xmyoot/esp32-c3-smart-scale/docs/client_request.md

Low Power PCB Design for ESP32-C3-Mini-1U with Load Cell and LiPo Support Summary
Need custom PCB design for a **low-power smart scale**.

Main requirements:

* ESP32-C3-MINI-1U
* Wi-Fi + BLE
* external antenna
* USB-C charging for 1S 3.7 V 3000 mAh battery
* battery level measurement
* load cell weight measurement
* very low sleep current
* factory programming pads
* compact, low-cost design

Deliverables:

* schematic
* PCB layout
* BOM
* Gerbers
* pick and place
* assembly files
* bring-up notes

Please recommend the cheapest sensible architecture, including:

* load-cell ADC
* charger IC
* battery measurement method
* regulators / power path
* low-power strategy

Board should be suitable for a real product, not a dev board clone.
