xmyoot/esp32-c3-smart-scale/docs/design_brief.html

ESP32-C3 Smart Scale

Engineering Design Brief | Rev A0 | 2026-04-02

Engineering Design Brief

# Low-Power ESP32-C3 Smart Scale Main Board

This project is a compact, battery-backed smart-scale PCB built around the ESP32-C3-MINI-1U with external antenna support, a dedicated HX711 load-cell ADC, USB-C charging for a 1S 3000 mAh LiPo, and explicit low-sleep-current design choices. The cheapest sensible product architecture is a battery-always-present system using a linear charger, a low-IQ 3.0 V rail, a switched battery divider, and direct USB Serial/JTAG routing into the ESP32-C3 so there is no USB-UART bridge tax.

<40 uA

Target Deep-Sleep Current
system-level goal, excluding charger leakage variance

24-bit

Weight Front End
HX711, 10 SPS preferred

3.0 V

Main Rail
chosen to fit ESP32-C3 supply window with low cost

500 mA

Charge Setpoint
initial recommendation for thermal and USB simplicity

45 × 35 mm

Board Envelope
explicit first-pass assumption

01

## Design Options

Recommended

Option A

### LDO-Based Battery-Backed Product Board

Use the battery as the always-present energy source, charge it from USB-C with MCP73831, regulate the system with a low-IQ TLV75530, and measure the bridge with HX711. Route USB D+/D- straight into the ESP32-C3 USB Serial/JTAG pins.

Pros

Lowest BOM cost while staying product-grade

No USB-UART bridge or power-path PMIC overhead

Simple firmware and assembly flow

Cons

Not optimized for battery-less USB operation

Active efficiency lower than a switching rail

Charge/load interaction must be budgeted

Verdict: best fit for “cheapest sensible architecture” and a battery-backed scale product.

Option B

### Buck-Regulated Battery System

Keep the same charger and metrology path, but replace the LDO with a low-IQ switching regulator. This improves active efficiency and thermal margin during Wi-Fi bursts.

Pros

Better energy use during radio activity

Lower thermal stress at higher average load

More headroom if the feature set grows

Cons

Higher BOM cost

More EMI and layout discipline required

Solves a problem the present use case may not have

Verdict: technically cleaner for efficiency, but not the cheapest sensible first product architecture.

Option C

### Premium Metrology + Power-Path Platform

Use a higher-spec ADC and a charger with full power-path behavior so the board behaves more like a mains-attached product while charging and running.

Pros

Best behavior with low battery during USB attach

More precision and firmware control headroom

Easier to scale into a more premium product tier

Cons

Breaks the low-cost target

Longer layout and bring-up cycle

Unnecessary complexity for the current brief

Verdict: reserve for a later revision if battery-less USB behavior or higher precision becomes mandatory.

Chosen Direction

Option A is the recommended baseline because the product is fundamentally battery-backed, the `ESP32-C3-MINI-1U` allows cheap direct USB programming, and the scale’s mostly-sleeping duty cycle does not justify a costlier switching power tree in the first revision.

02

## System Specification

### Power Chain

USB input | `USB-C`, sink-only, `5 V` default current | Use two `5.1 kΩ` CC pull-downs; no PD controller
Charger IC | `MCP73831T-2ACI/OT` ok | 4.2 V termination; set `500 mA` charge current initially
Main rail | `3.0 V` via `TLV75530PDBVR` ok | Chosen to stay inside module supply window while using most of the LiPo curve
Battery pack | `1S 3.7 V 3000 mAh` nominal | Always-installed assumption; no battery-less design target
Sleep-current target | `<40 uA` system goal goal | Depends on divider gating, HX711 power-down, and charger/leakage details

### Measurement Chain

Load-cell ADC | `HX711` ok | 24-bit weigh-scale front end; `10 SPS` preferred for noise performance
Bridge supply | From regulated system rail | Simplifies BOM and keeps analog domain referenced to main rail
Battery measurement | Switched divider into ESP32 ADC ok | Cheaper than a gauge and no always-on divider bleed
Calibration strategy | Zero + known reference mass | Factory coefficient stored in NVM
Optional optimization | PFET bridge gating optional | Use if the extra analog switch complexity is justified by sleep-current measurements

### Product Integration

MCU / radio | `ESP32-C3-MINI-1U-H4` ok | External antenna connector already integrated on module
Programming path | USB Serial/JTAG over same USB-C port | Route `GPIO19` to D+, `GPIO18` to D-
Factory pads | `GND`, `VBAT`, `3V0`, `EN`, `BOOT`, UART | Provides manufacturing and recovery access even if USB path is unavailable
Board stackup | 2-layer recommended for cost assumed | Enough if antenna keepout and analog partitioning are respected
Board size | `45 x 35 mm` assumed | Compact but still realistic for connector spacing and keepouts

Critical Constraint

This design assumes the battery is always fitted. If the product must boot and run cleanly from USB-C with an empty or disconnected battery, the charger section should move to a true power-path architecture in the next revision.

03

## System Schematic

Fig 1. System block diagram for the recommended architecture.

Fig 2. First-pass board floorplan and keepout concept.

Fig 3. Load-cell ADC detail, including the battery-divider side channel into the MCU.

04

## Bill of Materials

Ref | Description | Part Number | Qty | Est. Unit $ | Source
Core Compute + RF
U1 | Wi-Fi / BLE module with external antenna connector | ESP32-C3-MINI-1U-H4 LCSC: C3013922 | 1 | 2.56 | LCSC / JLCPCB
Weight Front End
U2 | 24-bit weigh-scale ADC | HX711 LCSC: C43656 | 1 | 0.59 | LCSC / JLCPCB
J3 | 4-pin load-cell connector | BM04B-SRSS-TB(LF)(SN) Assumed compact SMT connector | 1 | 0.20 | JST / Distributor
Battery + Charging
J1 | USB-C receptacle, 16-pin, USB 2.0, 3 A | TYPE-C-31-M-12 LCSC: C165948 | 1 | 0.40 | LCSC / JLCPCB
U3 | 1-cell Li-ion charger, 4.2 V regulation | MCP73831T-2ACI/OT LCSC: C424093 | 1 | 0.60 | LCSC / JLCPCB
J2 | 2-pin LiPo battery connector | S2B-PH-SM4-TB(LF)(SN) Hand-solder if assembly availability is poor | 1 | 0.16 | JST / Distributor
Regulation + Support
U4 | 3.0 V / 500 mA low-IQ LDO | TLV75530PDBVR LCSC: C507268 | 1 | 0.17 | LCSC / JLCPCB
D1 | USB ESD protection array | USBLC6-2SC6 Exact source to confirm during part import | 1 | 0.10 | LCSC / JLCPCB
Q1 | Optional PFET for bridge or divider gating | AO3401A Use only if sleep-current budget needs it | 1 | 0.03 | LCSC / JLCPCB
R* | CC resistors, charger set resistor, boot pulls, battery divider | 0402 / 0603 passives JLC stocked parts | ~12 | 0.01–0.03 | JLCPCB PCBA
C* | USB, battery, LDO, module, and ADC decoupling | 0402 / 0603 / 0805 MLCCs JLC stocked parts | ~10 | 0.01–0.04 | JLCPCB PCBA
Estimated electronics subtotal for core PCBA | | | | ~4.80 | Excludes PCB fab, assembly fees, battery, load cell, and external antenna

Sourcing Note

The USB connector, ESD diode, and harness connectors should be re-checked against the final enclosure and assembly strategy before release. Core IC recommendations are already anchored to live LCSC/JLC-friendly parts.

05

## Wiring & Assembly

Fig 4. Enclosure-level wiring concept showing the main PCB, LiPo pack, and load-cell harness.

01

Receive and inspect PCBs

Confirm board revision, USB-C connector footprint quality, module-pad finish, and antenna-edge keepout cleanliness before assembly.

02

Populate core power path

Verify `MCP73831`, `TLV75530`, CC resistors, bulk caps, and battery connector orientation before the ESP32 module is powered for the first time.

03

Mount MCU and analog front end

Assemble `ESP32-C3-MINI-1U`, `HX711`, and the related passives. Keep the analog zone clean and inspect for solder bridges around the HX711 inputs.

04

Install harness connectors

Attach the LiPo connector, load-cell connector, and any optional external-antenna pigtail or mating connector specified by the mechanical design.

05

Factory program and calibrate

Use USB Serial/JTAG through USB-C first; fall back to the factory pads if needed. Flash test firmware, read bridge counts, and apply a known-mass calibration.

06

Function test and sleep-current check

Verify charging, battery ADC, radio bring-up, load-cell stability, and the final deep-sleep current target with the bridge and divider disabled.

Serviceability

Keep the factory pads accessible even after enclosure integration. This board should be recoverable without desoldering the battery or opening the RF path.

06

## Production Ordering Guide

JLCPCB PCB + PCBA

Dimensions

45 mm × 35 mm (assumed)

Layers

2

Finish

ENIG preferred

PCBA type

Top-side assembly

Qty

5–10 proto / 100+ pilot

Estimated cost

Low single-digit PCB + assembly overhead, parts separate

Battery / Harness

Battery

1S LiPo, 3000 mAh

Load cell

4-wire bridge sensor

Connector strategy

Pre-crimped harness or manual crimp

Assembly

Likely hand-install in proto stage

Qty

Match PCB quantity + spares

Estimated cost

External to PCBA quote

Factory Fixture

Interface

Pogo fixture on factory pads

Primary flash path

USB-C + USB Serial/JTAG

Fallback

UART + EN + BOOT pads

Need

Current measurement + calibration mass

Qty

1–2 fixtures initially

Estimated cost

Project-specific fixture build

Files Needed To Place Orders

Gerbers, drill files, BOM CSV, pick-and-place CSV, assembly drawings, and a bring-up note package covering USB flashing, battery check, and load-cell calibration.

### Scale-Up Notes

- If the product must charge and run gracefully with a deeply depleted or missing battery, move to a real power-path charger in the next revision.
- If RF performance becomes enclosure-limited, reserve a future spin for antenna matching and feed optimization with the final mechanical stack.
- If sleep-current margin is not met, add explicit bridge-power gating instead of changing the whole analog architecture.

Document ID: E3S-A0-DESIGN-BRIEF | Revision A0 | Status: recommended architecture defined, pending circuit implementation and validation
