xmyoot/esp32-c3-smart-scale/docs/images/pcb_layout.png

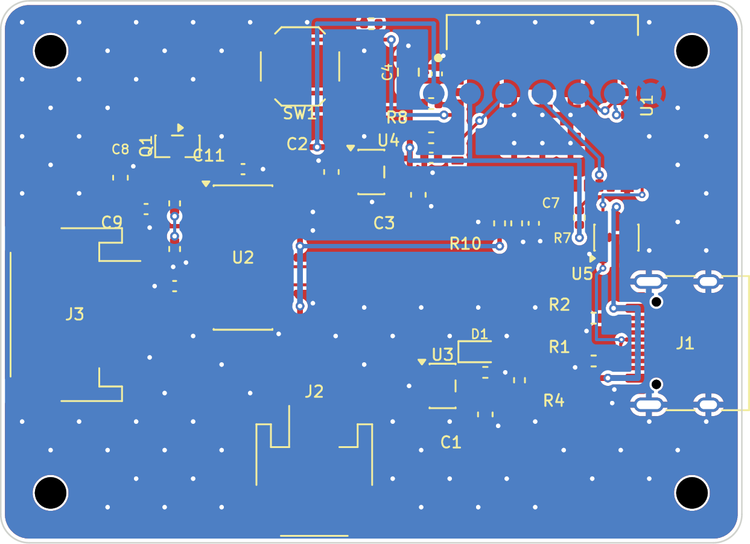
docs/images/pcb_layout.png
