xmyoot/esp32-c3-smart-scale/fab/assembly/bom_jlcpcb.csv

Comment | Designator | Footprint | LCSC Part # | MPN | Qty
4.7uF | C1 | C_0603_1608Metric | C19666 | CL10A475KO8NNNC | 1
10uF | C2,C3,C8 | C_0603_1608Metric | C19702 | CL10A106KP8NNNC | 3
22uF | C4 | C_0805_2012Metric | C45783 | CL21A226MAQNNNE | 1
100nF | C5,C7,C9,C10,C11 | C_0402_1005Metric | C1525 | CL05B104KO5NNNC | 5
1uF | C6 | C_0402_1005Metric | C52923 | CL05A105KA5NQNC | 1
CHG | D1 | LED_0603_1608Metric | C2286 | KT-0603R | 1
USB-C | J1 | USB_C_Receptacle_HRO_TYPE-C-31-M-12 | C165948 | TYPE-C-31-M-12 | 1
BATTERY | J2 | JST_PH_S2B-PH-SM4-TB_1x02-1MP_P2.00mm_Horizontal | C295747 | S2B-PH-SM4-TB(LF)(SN) | 1
LOAD CELL | J3 | JST_PH_S4B-PH-SM4-TB_1x04-1MP_P2.00mm_Horizontal | C265102 | S4B-PH-SM4-TB(LF)(SN) | 1
MMBT5401 | Q1 | SOT-23 | C8326 | MMBT5401 | 1
5.1k | R1,R2 | R_0402_1005Metric | C25905 | 0402WGF5101TCE | 2
2.2k | R3 | R_0402_1005Metric | C25879 | 0402WGF2201TCE | 1
1k | R4 | R_0402_1005Metric | C11702 | 0402WGF1001TCE | 1
10k | R5,R7,R8,R13 | R_0402_1005Metric | C25744 | 0402WGF1002TCE | 4
100k | R9 | R_0402_1005Metric | C25741 | 0402WGF1003TCE | 1
1M | R10 | R_0402_1005Metric | C26083 | 0402WGF1004TCE | 1
330k | R11 | R_0402_1005Metric | C25778 | 0402WGF3303TCE | 1
12k | R12 | R_0402_1005Metric | C25752 | 0402WGF1202TCE | 1
TARE/WAKE | SW1 | SW_Push_1P1T_XKB_TS-1187A | C318884 | TS-1187A-B-A-B | 1
ESP32-C3-MINI-1U | U1 | ESP32-C3-MINI-1U | C3013922 | ESP32-C3-MINI-1U-H4 | 1
HX711 | U2 | SOIC-16_3.9x9.9mm_P1.27mm | C43656 | HX711 | 1
MCP73831 | U3 | SOT-23-5 | C424093 | MCP73831T-2ACI/OT | 1
TLV75530 | U4 | SOT-23-5 | C507268 | TLV75530PDBVR | 1
USBLC6-2SC6 | U5 | SOT-23-6 | C7519 | USBLC6-2SC6 | 1
