xmyoot/esp32-c3-smart-scale/dist/exports/preliminary-bom.csv

Reference | MPN | JLCPCB | Type
J1 | TYPE_C_31_M_12 | C165948 | simple_chip
U3 | MCP73831T_2ACI_OT | C424093 | simple_chip
U4 | TLV75530PDBVR | C507268 | simple_chip
J2 | S2B-PH-SM4-TB_LF__SN_ |  | simple_chip
R1 |  | C25905|C2906874|C2906948 | simple_resistor
R2 |  | C25905|C2906874|C2906948 | simple_resistor
R3 |  | C4109|C2909344|C25552 | simple_resistor
C1 |  | C19702|C96446|C1691 | simple_capacitor
C2 |  | C19666|C1705|C6119856 | simple_capacitor
C3 |  | C19666|C1705|C6119856 | simple_capacitor
C4 |  | C19702|C96446|C1691 | simple_capacitor
U1 | ESP32_C3_MINI_1U_H4 | C3013922 | simple_chip
R4 |  | C25744|C60490|C25531 | simple_resistor
C5 |  | C52923|C14445|C29266 | simple_capacitor
R5 |  | C25744|C60490|C25531 | simple_resistor
C6 |  | C19702|C96446|C1691 | simple_capacitor
C7 |  | C1525|C307331|C60474 | simple_capacitor
R6 |  | C22276|C138034|C2930014 | simple_resistor
R7 |  | C2998054|C25793|C137971 | simple_resistor
U2 | HX711 | C43656 | simple_chip
J3 | LOAD_CELL_4P_GENERIC |  | simple_chip
C8 |  | C1525|C307331|C60474 | simple_capacitor
C9 |  | C19702|C96446|C1691 | simple_capacitor
TP1 | FACTORY_PADS_7 |  | simple_chip
