xmyoot/esp32-c3-smart-scale/fab/esp32-c3-smart-scale.step

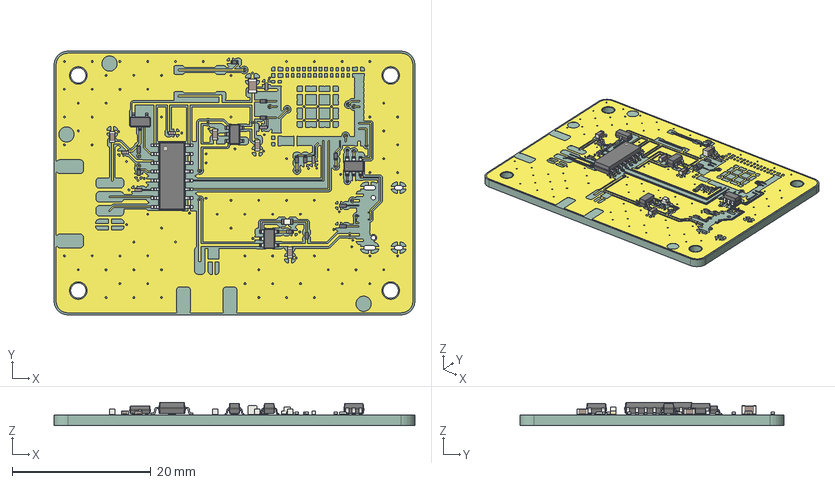
[picture p2: CAD file, 2026-10-22]
fab/esp32-c3-smart-scale.step
52.0 x 38.0 x 3.38 mm
R_0402_1005Metric x 12
C_0603_1608Metric x 4
C_0402_1005Metric x 6
SOT-23-6
SOT-23
SOT-23-5 x 2
C_0805_2012Metric
LED_0603_1608Metric
SOIC-16_3.9x9.9mm_P1.27mm
esp32-c3-smart-scale_copper
esp32-c3-smart-scale_via
esp32-c3-smart-scale_PCB
