xmyoot/esp32-c3-smart-scale/kicad/esp32-c3-smart-scale.kicad_pcb

## KiCad design kicad/esp32-c3-smart-scale.kicad_pcb (2026-10-22)

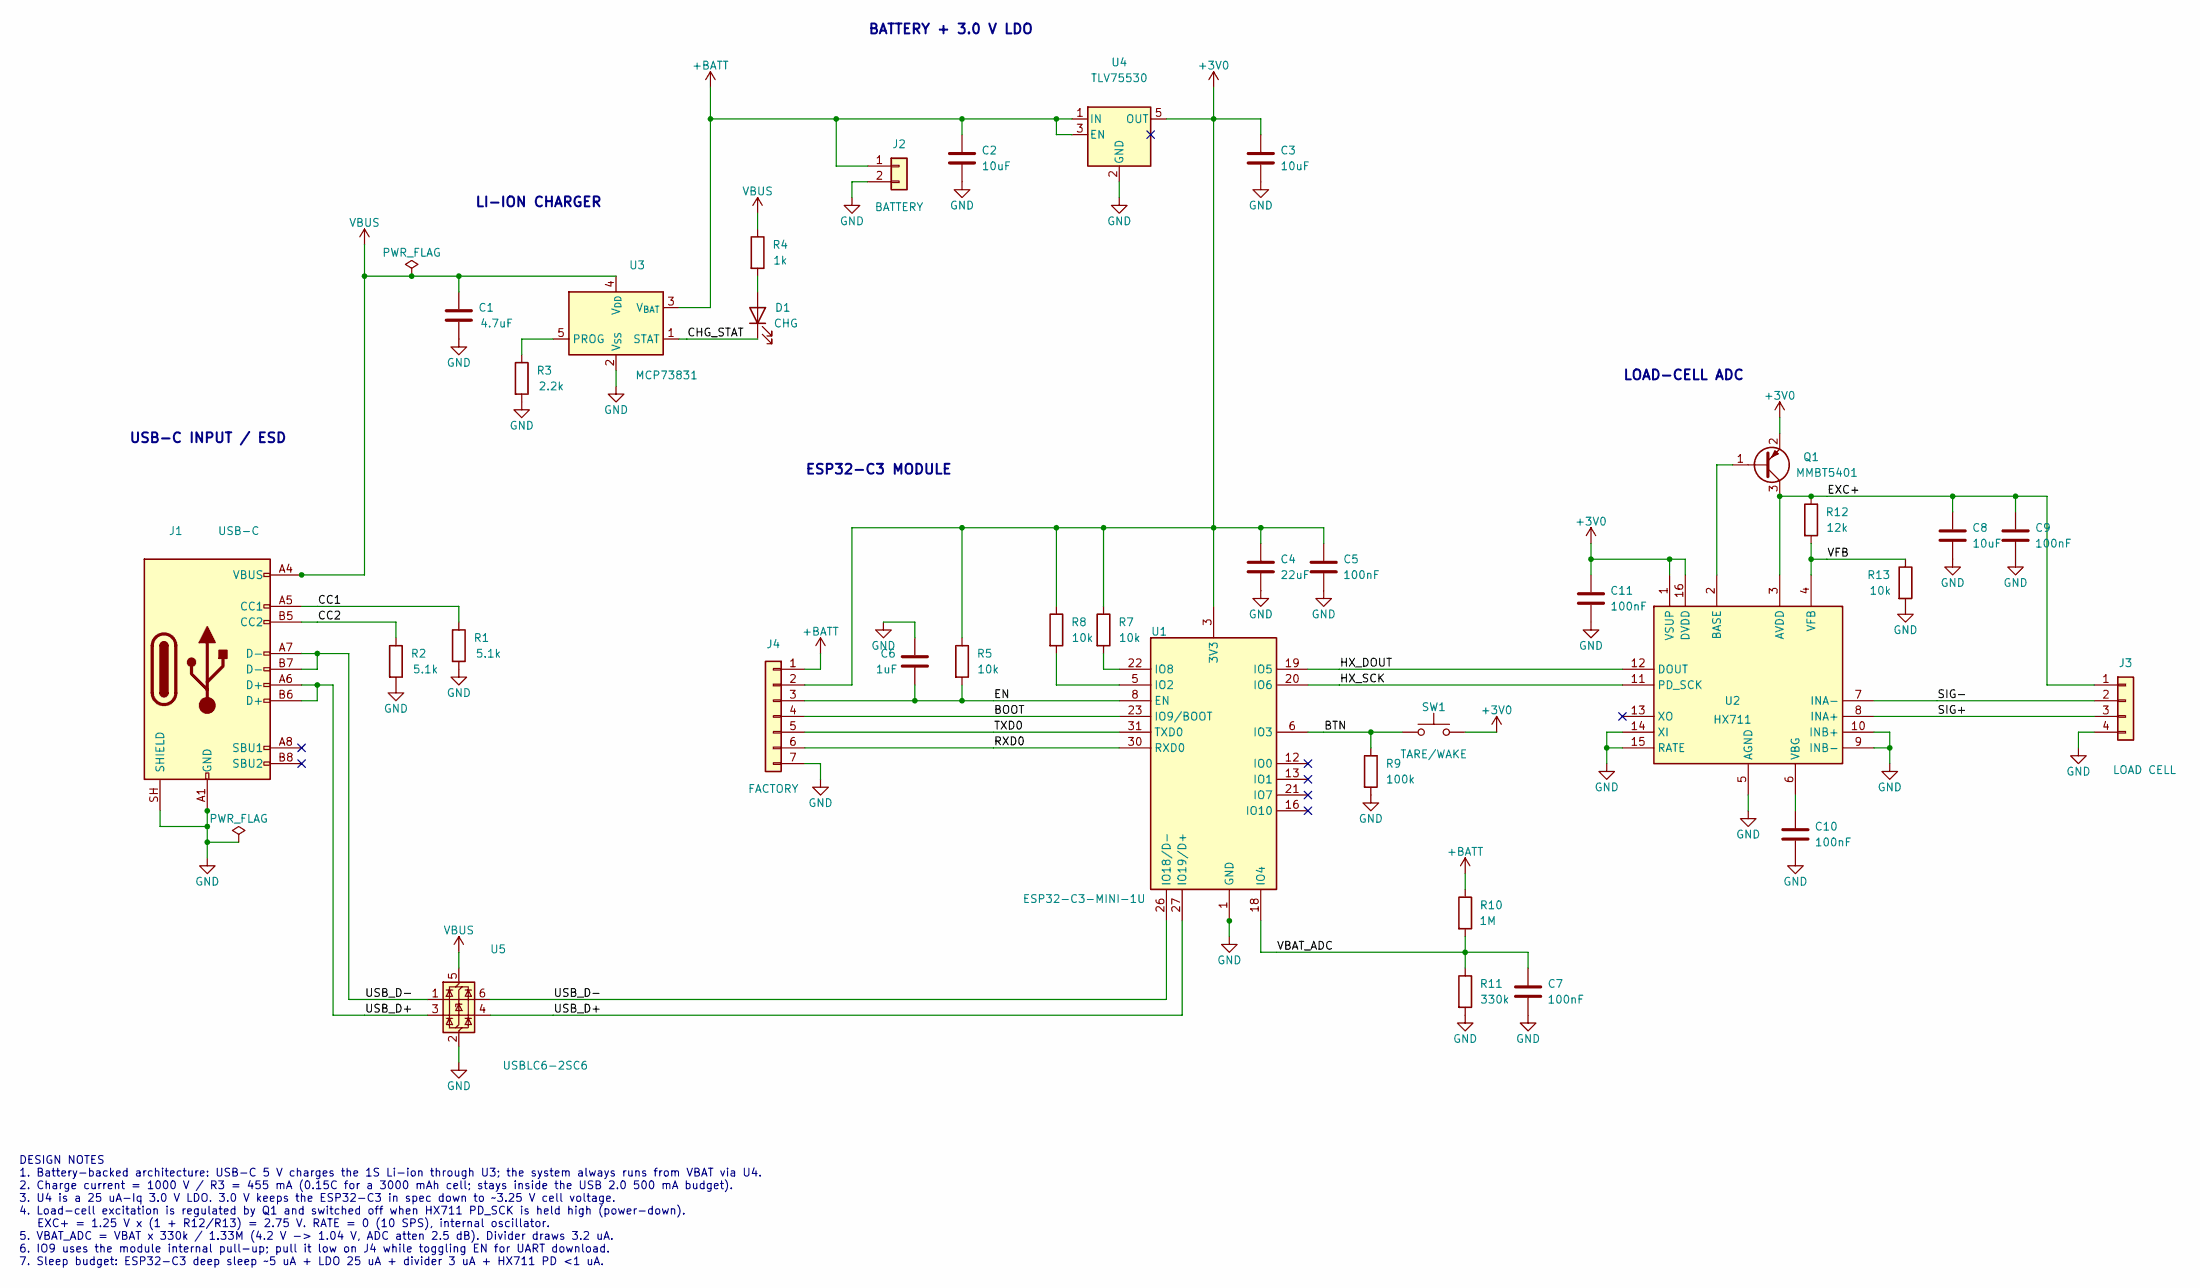
[picture p4: schematic esp32-c3-smart-scale.kicad_sch, ESP32-C3 Smart Scale - Main Board]

Parts:
C1: 4.7uF; C_0603_1608Metric; MPN CL10A475KO8NNNC; LCSC C19666
C2, C3, C8: 10uF; C_0603_1608Metric; MPN CL10A106KP8NNNC; LCSC C19702
C4: 22uF; C_0805_2012Metric; MPN CL21A226MAQNNNE; LCSC C45783
C5, C7, C9, C10, C11: 100nF; C_0402_1005Metric; MPN CL05B104KO5NNNC; LCSC C1525
C6: 1uF; C_0402_1005Metric; MPN CL05A105KA5NQNC; LCSC C52923
D1: CHG; LED_0603_1608Metric; MPN KT-0603R; LCSC C2286
J1: USB-C; USB_C_Receptacle_HRO_TYPE-C-31-M-12; MPN TYPE-C-31-M-12; LCSC C165948
J2: BATTERY; JST_PH_S2B-PH-SM4-TB_1x02-1MP_P2.00mm_Horizontal; MPN S2B-PH-SM4-TB(LF)(SN); LCSC C295747
J3: LOAD CELL; JST_PH_S4B-PH-SM4-TB_1x04-1MP_P2.00mm_Horizontal; MPN S4B-PH-SM4-TB(LF)(SN); LCSC C265102
J4: FACTORY; FactoryPads_1x07_P2.54mm; MPN Bare pogo pads (no part)
Q1: MMBT5401; SOT-23; MPN MMBT5401; LCSC C8326
R1, R2: 5.1k; R_0402_1005Metric; MPN 0402WGF5101TCE; LCSC C25905
R3: 2.2k; R_0402_1005Metric; MPN 0402WGF2201TCE; LCSC C25879
R4: 1k; R_0402_1005Metric; MPN 0402WGF1001TCE; LCSC C11702
R5, R7, R8, R13: 10k; R_0402_1005Metric; MPN 0402WGF1002TCE; LCSC C25744
R9: 100k; R_0402_1005Metric; MPN 0402WGF1003TCE; LCSC C25741
R10: 1M; R_0402_1005Metric; MPN 0402WGF1004TCE; LCSC C26083
R11: 330k; R_0402_1005Metric; MPN 0402WGF3303TCE; LCSC C25778
R12: 12k; R_0402_1005Metric; MPN 0402WGF1202TCE; LCSC C25752
SW1: TARE/WAKE; SW_Push_1P1T_XKB_TS-1187A; MPN TS-1187A-B-A-B; LCSC C318884
U1: ESP32-C3-MINI-1U; MPN ESP32-C3-MINI-1U-H4; LCSC C3013922
U2: HX711; SOIC-16_3.9x9.9mm_P1.27mm; MPN HX711; LCSC C43656
U3: MCP73831; SOT-23-5; MPN MCP73831T-2ACI/OT; LCSC C424093
U4: TLV75530; SOT-23-5; MPN TLV75530PDBVR; LCSC C507268
U5: USBLC6-2SC6; SOT-23-6; MPN USBLC6-2SC6; LCSC C7519

Connections:
+3V0: C3.1, C4.1, C5.1, C11.1, J4.2, Q1.2 (E), R5.1, R7.1, R8.1, SW1.2, U1.3 (3V3), U2.1 (VSUP), U2.16 (DVDD), U4.5 (OUT)
+BATT: C2.1, J2.1, J4.1, R10.1, U3.3 (V_{BAT}), U4.1 (IN), U4.3 (EN)
/BOOT: J4.4, U1.23 (IO9/BOOT)
/BTN: R9.1, SW1.1, U1.6 (IO3)
/CC1: J1.A5 (CC1), R1.1
/CC2: J1.B5 (CC2), R2.1
/CHG_STAT: D1.1 (K), U3.1 (STAT)
/EN: C6.2, J4.3, R5.2, U1.8 (EN)
/EXC+: C8.1, C9.1, J3.1, Q1.3 (C), R12.1, U2.3 (AVDD)
/HX_DOUT: U1.19 (IO5), U2.12 (DOUT)
/HX_SCK: U1.20 (IO6), U2.11 (PD_SCK)
/RXD0: J4.6, U1.30 (RXD0)
/SIG+: J3.3, U2.8 (INA+)
/SIG-: J3.2, U2.7 (INA-)
/TXD0: J4.5, U1.31 (TXD0)
/USB_D+: J1.A6 (D+), J1.B6 (D+), U1.27 (IO19/D+), U5.3 (I/O2), U5.4 (I/O2)
/USB_D-: J1.A7 (D-), J1.B7 (D-), U1.26 (IO18/D-), U5.1 (I/O1), U5.6 (I/O1)
/VBAT_ADC: C7.1, R10.2, R11.1, U1.18 (IO4)
/VFB: R12.2, R13.1, U2.4 (VFB)
GND: C1.2, C2.2, C3.2, C4.2, C5.2, C6.1, C7.2, C8.2, C9.2, C10.2, C11.2, J1.A1 (GND), J1.A12 (GND), J1.B1 (GND), J1.B12 (GND), J1.SH (SHIELD), J2.2, J3.4, J4.7, R1.2, R2.2, R3.2, R9.2, R11.2, R13.2, U1.1 (GND), U1.2 (GND), U1.11 (GND), U1.14 (GND), U1.36 (GND), U1.37 (GND), U1.38 (GND), U1.39 (GND), U1.40 (GND), U1.41 (GND), U1.42 (GND), U1.43 (GND), U1.44 (GND), U1.45 (GND), U1.46 (GND), U1.47 (GND), U1.48 (GND), U1.49 (GND), U1.50 (GND), U1.51 (GND), U1.52 (GND), U1.53 (GND), U1.54 (GND), U1.55 (GND), U1.56 (GND), U1.57 (GND), U1.58 (GND), U1.59 (GND), U1.60 (GND), U1.61 (GND), U2.5 (AGND), U2.9 (INB-), U2.10 (INB+), U2.14 (XI), U2.15 (RATE), U3.2 (V_{SS}), U4.2 (GND), U5.2 (GND)
unnamed: D1.2 (A), R4.2
unnamed: Q1.1 (B), U2.2 (BASE)
unnamed: R8.2, U1.5 (IO2)
unnamed: R7.2, U1.22 (IO8)
unnamed: C10.1, U2.6 (VBG)
unnamed: R3.1, U3.5 (PROG)
VBUS: C1.1, J1.A4 (VBUS), J1.A9 (VBUS), J1.B4 (VBUS), J1.B9 (VBUS), R4.1, U3.4 (V_{DD}), U5.5 (VBUS)

Notes on the sheet:
DESIGN NOTES 1. Battery-backed architecture: USB-C 5 V charges the 1S Li-ion through U3; the system always runs from VBAT via U4. 2. Charge current = 1000 V / R3 = 455 mA (0.15C for a 3000 mAh cell; stays inside the USB 2.0 500 mA budget). 3. U4 is a 25 uA-Iq 3.0 V LDO. 3.0 V keeps the ESP32-C3 in 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
USB-C INPUT / ESD
LI-ION CHARGER
BATTERY + 3.0 V LDO
ESP32-C3 MODULE
LOAD-CELL ADC

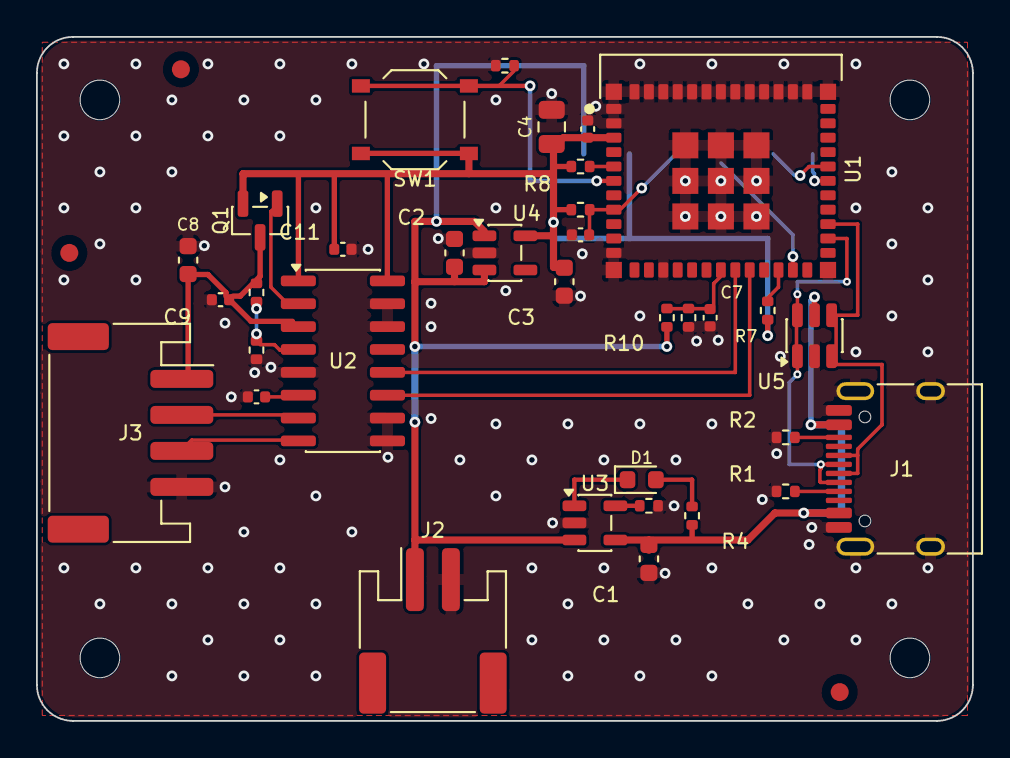
[picture p5: board esp32-c3-smart-scale.kicad_pcb from above]

Board: 2 copper layers, 52.0 x 38.0 mm, 42 parts (1 on the bottom side), 27 nets.

Other parts of the board:
FID1, FID2, FID3: Fiducial_1mm_Mask2mm
H1, H2, H3, H4: MountingHole_2.2mm_M2
