xmyoot/esp32-c3-smart-scale/(commit log)

2026-04-02 Implement smart-scale board and validate layout
2026-04-02 Document outputs and current build status
2026-10-22 Native KiCad 10 design: schematic, PCB layout and fab outputs
    - Single-sheet, fully wired KiCad schematic (ERC clean)
    - 52x38 mm 2-layer PCB, 100% routed, DRC and schematic parity clean
    - HX711 excitation now switched via external PNP for low sleep current
    - Added USB ESD, charge LED, tare/wake button, underside pogo pads
    - JLCPCB Gerbers, BOM (LCSC), CPL, STEP, schematic PDF, 3D renders
    - Architecture, design review and bring-up documentation
    - tscircuit prototype kept for reference under docs/legacy_tscircuit
